hdh7485/AVEES_scale_car/image/모터 드라이버 캡처 이미지.docx

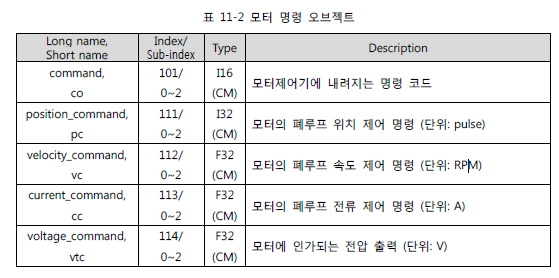
[picture p3: figure]
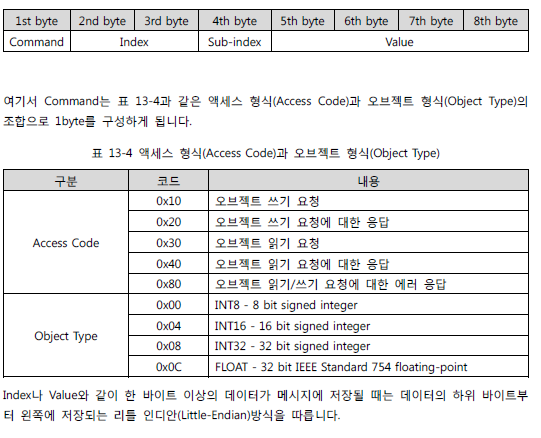
[picture p4: figure]
