hdh7485/AVEES_scale_car/Steering_motor_test.xlsx

입력 전압(V) | 각속도(deg/sec) | 입력전압 | 각속도 | 배터리 전압 | 52.4
0 | 0 | 0 | 0
1 | 0 | -1 | 0
2 | 0 | -2 | 0
3 | 0 | -7 | 0
3.1 | 0 | -8 | 0
3.2 | 50 | -8.1 | 0
3.21 | 55 | -8.2 | 1
3.3 | 55 | -8.3 | 7
3.35 | 60 | -8.4 | 10
3.4 | 60 | -8.5 | 15
3.45 | 65 | -8.55 | 17
3.5 | 67 | -8.6 | 20
3.55 | 70 | -8.65 | 22
3.6 | 70 | -8.7 | 25
3.65 | 72 | -8.75 | 27
3.7 | 72 | -8.8 | 30
3.75 | 75 | -8.85 | 32
3.8 | 77 | -8.9 | 32
3.85 | 80 | -8.95 | 35
3.9 | 82 | -9 | 37
3.95 | 85 | -9.05 | 40
4 | 87 | -9.1 | 42
4.05 | 87 | -9.15 | 45
4.1 | 90 | -9.2 | 45
4.15 | 92 | -9.25 | 47
4.2 | 93 | -9.3 | 50
4.25 | 95 | -9.35 | 52
4.3 | 97 | -9.4 | 52
4.35 | 100 | -9.45 | 55
4.4 | 100 | -9.5 | 55
4.45 | 102 | -9.55 | 60
4.5 | 103 | -9.6 | 62
4.55 | 105 | -9.65 | 62
4.6 | 107 | -9.7 | 65
4.65 | 110 | -9.75 | 67
4.7 | 112 | -9.8 | 70
4.75 | 115 | -9.85 | 70
4.8 | 117 | -9.9 | 72
4.85 | 120 | -9.95 | 75
4.9 | 122 | -10 | 77
4.95 | 122 | -10.05 | 77
5 | 125 | -10.1 | 80
5.05 | 127 | -10.15 | 82
5.1 | 127 | -10.2 | 85
 |  | -10.25 | 87
 |  | -10.3 | 90
 |  | -10.35 | 90
 |  | -10.4 | 92
 |  | -10.45 | 95
 |  | -10.5 | 95
 |  | -10.55 | 97
 |  | -10.6 | 97
 |  | -10.65 | 100
 |  | -10.7 | 102
 |  | -10.75 | 102
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
