hdh7485/AVEES_scale_car/MoonWalker Motor Control UI Utitity v1.10/MotorControlUI.ini

[Property]
scanBegin=1
scanEnd=2
canBitrate=0
comBaudrate=4
trTimeout=100
_tabSel=1
_autoUpdate=0
_winSx=448
_winSy=367
_showPlot=0
_plotSx=123
_plotSy=135
_plotDx=994
_plotDy=474
_valueRange=40
_updateTimeout=3000
_splitterHor=449
_splitterVer=754
_listVarCol1=20
_listVarCol2=80
_listVarCol3=80
_graphVariable1=1
_graphVariable2=2
_graphVariable3=10
_graphVariable4=11
_graphVariable5=12
_graphVariable6=13
_graphVariable7=0
_graphVariable8=0
_graphChannel1=0
_graphChannel2=0
_graphChannel3=1
_graphChannel4=1
_graphChannel5=1
_graphChannel6=1
_graphChannel7=0
_graphChannel8=0
_graphScale1=9
_graphScale2=9
_graphScale3=9
_graphScale4=9
_graphScale5=9
_graphScale6=9
_graphScale7=9
_graphScale8=9
_graphColor1=255
_graphColor2=8454143
_graphColor3=8421631
_graphColor4=8454016
_graphColor5=8323199
_graphColor6=8355584
_graphColor7=128
_graphColor8=32768
_scriptFile=scr\ex4_motor_cooling.scr
_updateFile=C:\Users\HP\Desktop\MW_DCX.bin
_updateCom=\\.\COM13
