hdh7485/AVEES_scale_car/(commit log)

2017-08-07 Add: add two arduino files; receive_CAN & send_CAN. receive_CAN is working by a arduino & two arduino shield. #9 shield is position at top and #10 shield at between arduino and #9 shield.
2017-08-07 Modify: fix arduino& can bus description.
2017-08-10 Add: add steering receive using CAN.
2017-08-10 Modify: add angle sensor discription.
2017-08-14 Modify: send CAN message for scale car motor driver.
2017-08-17 Modify: Fix motor stop and on.
    [DC_motor_CAN.ino]
2017-08-17 Add: arduino DC_motor_voltage_control.
2017-08-21 Add: steer control.
2017-08-21 Modify: fix steering control.
    [Steer_control_and_RC.ino]
2017-08-22 Add: arduino files
2017-08-23 Add: 24V DC motor name.
2017-08-25 Add: excel file.
    [Steering_motor_test.xlsx]
2017-09-04 Add: steer and run.
    [angle_sensor분석.xlsx]
2017-09-07 Add: Steer and run code.
2017-09-11 Add: mstimer and steer_and_run_interrupt.
2017-09-11 Add: interrupt
2017-09-11 Modify: delete timerinterrupt() from ISR().
2017-09-13 Remove: Timer Interrupt.
2017-09-14 Steer and run timerone success!!!!!!
2017-09-29 Add: detect serial not input to arduino.
